Mottramlabs/4-Channel-Mains-Current-Sensor-ESP8266/Pictures/Dims.png

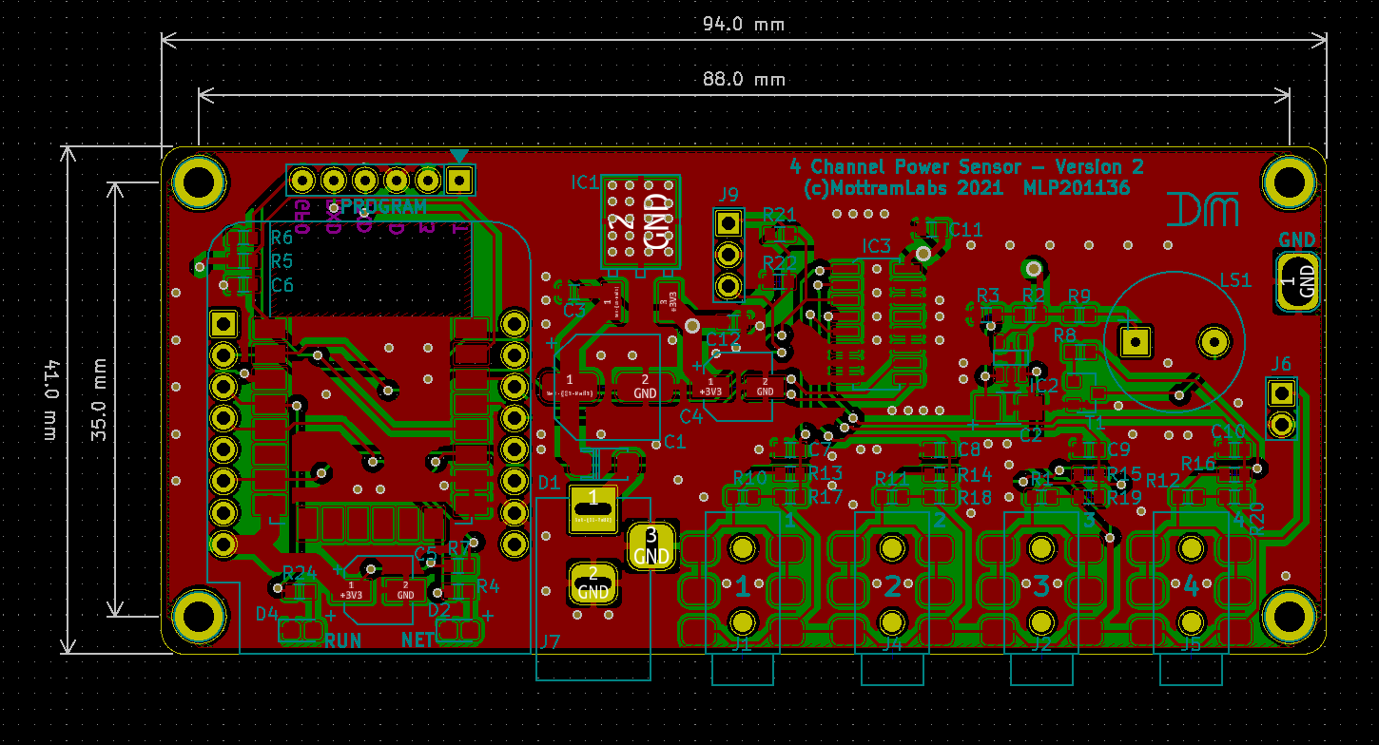
Pictures/Dims.png
