Mottramlabs/4-Channel-Mains-Current-Sensor-ESP8266/SCH201136.pdf

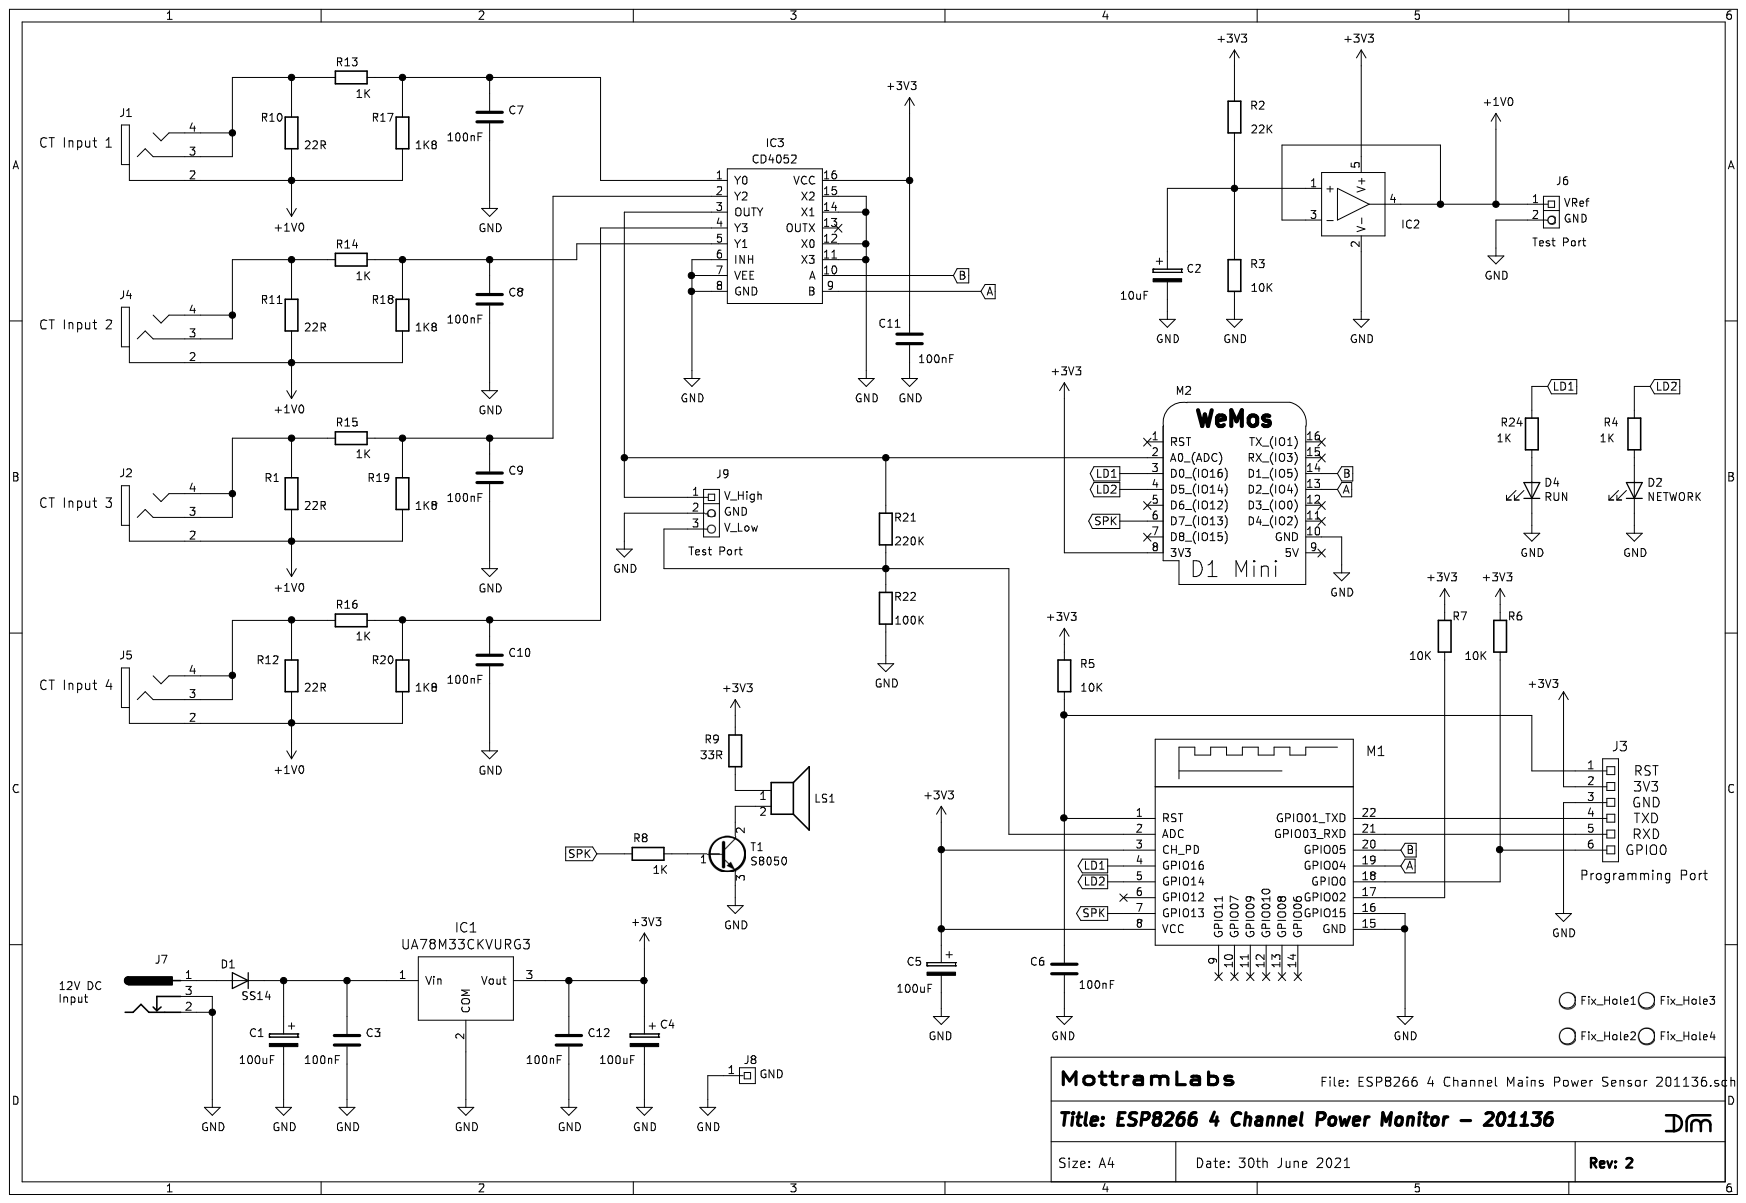
[picture p3: page 1]
