Mottramlabs/4-Channel-Mains-Current-Sensor-ESP8266/(threads)

Thread 1 (2021-08-17):

ESPHome Support

jamestutton, 2021-08-17:
Hi just wondering if you had considered ESPHome support for this module.  They already have CT Clamp Support so would just need some way of working with the multiplexer.

Mottramlabs, 2021-08-22:
I've only just started using ESPHome so still a lot to learn. I have tried my single channel board with the CT Clamp module and it worked well, so now I just need to figure out how to control the GPIO pins used for the multiplexer. I may need help with this, I can't find the source code for the CT Clamp module.

jamestutton, 2021-08-23:
The esphome ct_clamp code is here:

https://github.com/esphome/esphome/tree/5c65f9f9ad8af021f0d73cb0eb12babd2b784c1a/esphome/components/ct_clamp

So again not had the time to deep dive but guessing the basic principle would be set create a fork of this module:

- Set an enabled channels flag.
- Cycle through each enabled channel on the multiplexer by setting correct GPIO states:
- Then have 4 return values that get published.

Or just cycle through all 4 channels with a bit less resolution/refresh time.

jamestutton, 2021-08-23:
Could probably use something like DHT12

https://github.com/esphome/esphome/tree/5c65f9f9ad8af021f0d73cb0eb12babd2b784c1a/esphome/components/dht12

To model the idea of returning multiple values, but instead of temp + humidity you return channel1,2,3,4

GPIO PIN Stuff should be as simple as

```
this->pin_d1->digital_write(true);
this->pin_d2->digital_write(false);

```

daveabbott007, 2021-09-07:
Hi all, i am not a software guy by any means, but through the powers of cut and paste I have managed to work out a dirty workaround to get this board working with ESPhome.
my setup is 100a on ct1 (main feed) and 30a's on ct's 2,3 and 4. (house rings).
please use at your ow risk etc etc and if someone can improve it please share!

`substitutions:
  update_time: never
  disp_name: power-meter
  ic1Volts: "240"

esphome:
  name: power-meter
  platform: ESP8266
  board: d1_mini

logger:
  level: DEBUG
api:
captive_portal:
web_server:
  port: 80
ota:
wifi:
  ssid: "wifi ssid"
  password: "wifi pass"

time:
  - platform: homeassistant
    id: homeassistant_time

#.......................................
#...Below script sets up PIN A and B ...
#......then tells CT# to update.........
#.......................................

interval:
  - interval: 15s
    then:
      - script.execute: readCTs
script:
  - id: readCTs
    then:
    # A	B  CT
    # 0	0  1
    # 1	0  3
    # 0	1  2
    # 1	1  4
    # setup for CT1 A=0 B=0 - ct1Amps
      - output.turn_off: pinA
      - output.turn_off: pinB
      - delay: 2s
      - component.update: ct1Amps
      - delay: 500ms
      - component.update: ct1Watts
      - delay: 500ms
    # setup for CT2 A=1 B=0 - ct2Amps
      - output.turn_off: pinA
      - output.turn_on: pinB
      - delay: 2s
      - component.update: ct2Amps
      - delay: 500ms
      - component.update: ct2Watts
      - delay: 500ms
    # setup for CT3 A=0 B=1 - ct3Amps
      - output.turn_on: pinA
      - output.turn_off: pinB
      - delay: 2s
      - component.update: ct3Amps
      - delay: 500ms
      - component.update: ct3Watts
      - delay: 500ms
    # setup for CT4 A=1 B=1 - ct4Amps
      - output.turn_on: pinA
      - output.turn_on: pinB
      - delay: 2s
      - component.update: ct4Amps
      - delay: 500ms
      - component.update: ct4Watts
      - delay: 500ms

switch:
  - platform: restart
    name: "Restart"

output:
  - platform: gpio
    pin: D1
    id: pinB
  - platform: gpio
    pin: D2
    id: pinA

sensor:
  - platform: wifi_signal
    name: "wifi_signal"
    update_interval: 1min
  - platform: uptime
    name: "uptime"
    id: Uptime
    update_interval: 1min

  - platform: adc
    pin: A0
    id: adc_sensor
#    attenuation: 11db #esp32 only

  - platform: ct_clamp
    sensor: adc_sensor
    name: ct1Amps
    id: ct1Amps
    unit_of_measurement: A
    accuracy_decimals: 5
    sample_duration: 200ms
    update_interval: ${update_time}
    filters:
      - calibrate_linear:
          # Measured value of 0 maps to 0A
          - 0 -> 0
          # Known load: 4.0A
          # Value shown in logs: 0.1333A - 4.79=5.09
          - 0.00358  -> 4.4866

  - platform: ct_clamp
    sensor: adc_sensor
    name: ct2Amps
    id: ct2Amps
    unit_of_measurement: A
    accuracy_decimals: 5
    sample_duration: 200ms
    update_interval: ${update_time}
    filters:
      - calibrate_linear:
          - 0 -> 0
          - 0.00298175  -> 2.060

  - platform: ct_clamp
    sensor: adc_sensor
    name: ct3Amps
    id: ct3Amps
    unit_of_measurement: A
    accuracy_decimals: 5
    sample_duration: 200ms
    update_interval: ${update_time}
    filters:
      - calibrate_linear:
          # Measured value of 0 maps to 0A
          - 0 -> 0
          # Known load: 4.0A
          # Value shown in logs: 0.1333A
          - 0.1333 -> 4.0

  - platform: ct_clamp
    sensor: adc_sensor
    name: ct4Amps
    id: ct4Amps
    unit_of_measurement: A
    accuracy_decimals: 5
    sample_duration: 200ms
    update_interval: ${update_time}
    filters:
      - calibrate_linear:
          # Measured value of 0 maps to 0A
          - 0 -> 0.
          # Known load: 4.0A
          # Value shown in logs: 0.1333A
          - 0.1333 -> 4.0

#Watts per channel
  - platform: template
    name: ${disp_name} CT1 Watts
    id: ct1Watts
    lambda: return id(ct1Amps).state * ${ic1Volts};
    accuracy_decimals: 0
    unit_of_measurement: W
    icon: "mdi:flash-circle"
    update_interval: ${update_time} 
  - platform: template
    name: ${disp_name} CT2 Watts
    id: ct2Watts
    lambda: return id(ct2Amps).state * ${ic1Volts};
    accuracy_decimals: 0
    unit_of_measurement: W
    icon: "mdi:flash-circle"
    update_interval: ${update_time} 
  - platform: template
    name: ${disp_name} CT3 Watts
    id: ct3Watts
    lambda: return id(ct3Amps).state * ${ic1Volts};
    accuracy_decimals: 0
    unit_of_measurement: W
    icon: "mdi:flash-circle"
    update_interval: ${update_time} 
  - platform: template
    name: ${disp_name} CT4 Watts
    id: ct4Watts
    lambda: return id(ct4Amps).state * ${ic1Volts};
    accuracy_decimals: 0
    unit_of_measurement: W
    icon: "mdi:flash-circle"
    update_interval: ${update_time}

#Total Amps
  - platform: template
    name: ${disp_name} Total Amps
    id: totalAmps
    lambda: return id(ct1Amps).state ;
    accuracy_decimals: 2
    unit_of_measurement: A
    icon: "mdi:flash"
    update_interval: 15s 
#Total Watts
  - platform: template
    name: ${disp_name} Total Watts
    id: totalWatts
    lambda: return id(totalAmps).state * 230;
    accuracy_decimals: 1
    unit_of_measurement: W
    icon: "mdi:flash-circle"
    update_interval: 15s
#kWh
  - platform: total_daily_energy
    name: ${disp_name} Total kWh
    power_id: totalWatts
    filters:
      - multiply: 0.001
    unit_of_measurement: kWh

    `

GwelforBodad, 2021-09-29:
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

I don't use Home Assistant but like the idea of being able to enable/disable channels and specify CT parameters without having to recompile the sketch and upload over the air.  Therefore, I'm thinking of putting default values into my code but with the ability to update which channels are enabled and CT parameters using an MQTT configuration topic.  Thanks for the idea.

Morodin8, 2021-11-17:
Hi,
Thanks for the yaml @daveabbott007, tried it but just getting a steady `[D][sensor:113]: 'ct1Amps': Sending state 0.00049 A with 5 decimals of accuracy` with power on & off.
@jamestutton did you have to make any modifactions, apart from wifi etc. to get it working?

Morodin8, 2021-11-21:
Hi,
I tried another D1 mini & it now works. I assume it was my dodgy soldering skills on the other board.
Thanks again @daveabbott007!

scadman1, 2022-04-11:
Hi,

@Morodin8, can you confirm what version of the 4 channel Mottram Labs board this worked on please? Version 1 (Green PCB) or 2 (Blue PCB) or shouldn't it matter?

Morodin8, 2022-04-19:
It was the blue v2 PCB, I don't believe the script is needed for the green v1 PCB but not sure as I don't have the v1.

scadman1, 2022-04-25:
Hi Mondin8, many thanks for clarifying that for me. I now have v2 PCB and it all seems to be working however I'm struggling to get the calibration accurate. I have four SCT-013-000 100A/50mA current transformers. Any direction on this would be very much appreciated.

scadman1, 2022-04-26:
Many thanks again for the response. I'm extremely new to ESP programming and I think I may have taken on a little more than maybe I should have. I think I have something wrong with my code as it seems to add the values of the CT's together. Even without clipping them over the wire I'm getting power readings back unless they are set without filtering.

scadman1, 2022-04-28:
Hi Mondin8, are you using the Version 2 board with a D1 Mini ESP32? I ask as according to the ESPHome documentation, **The Analog To Digital (adc) Sensor allows you to use the built-in ADC in your device to measure a voltage on certain pins. On the ESP8266 only pin A0 (GPIO17) supports this. On the ESP32 pins GPIO32 through GPIO39 can be used.** I think that might explain why I can only get an accumulative value.

Morodin8, 2022-04-30:
I'm using the v2 board with ESP8266, that is why @daveabbott007's script is nescasary.

```
substitutions:
  pin_set_delay: 1s
  component_update_delay: 450ms
  update_time: 8s # must be > (pin_set_delay+component_update_delay*2) * channels

#.......................................
#...Below script sets up PIN A and B ...
#......then tells CT# to update.........
#.......................................

interval:
  - interval: ${update_time}
    then:
      - script.execute: readCTs
script:
  - id: readCTs
    then:
    # A	B:  CT
    # 0	0:  1
    # 0	1:  2
    # 1	0:  3
    # 1	1:  4
    # setup for CT1 A=0 B=0 - ct1Amps
      - output.turn_off: pinA
      - output.turn_off: pinB
      - delay: ${pin_set_delay}
      - component.update: ct1Amps
      - delay: ${component_update_delay}
      - component.update: ct1Watts
      - delay: ${component_update_delay}
    # setup for CT2 A=0 B=1 - ct2Amps
      - output.turn_off: pinA
      - output.turn_on: pinB
      - delay: ${pin_set_delay}
      - component.update: ct2Amps
      - delay: ${component_update_delay}
      - component.update: ct2Watts
      - delay: ${component_update_delay}
    # setup for CT3 A=1 B=0 - ct3Amps
      - output.turn_on: pinA
      - output.turn_off: pinB
      - delay: ${pin_set_delay}
      - component.update: ct3Amps
      - delay: ${component_update_delay}
      - component.update: ct3Watts
      - delay: ${component_update_delay}
    # setup for CT4 A=1 B=1 - ct4Amps
      - output.turn_on: pinA
      - output.turn_on: pinB
      - delay: ${pin_set_delay}
      - component.update: ct4Amps
      - delay: ${component_update_delay}
      - component.update: ct4Watts
      - delay: ${component_update_delay}

output:
  - platform: gpio
    pin: D1
    id: pinB
  - platform: gpio
    pin: D2
    id: pinA

sensor:
  - platform: adc
    pin: A0
    id: adc_sensor
```

scadman1, 2022-04-30:
Thank you so much, it was about the timings.

Morodin8, 2022-04-30:
No problem, glad to help.

jimmyeao, 2022-08-09:
Can someone share the full ESPHOME yaml please? I'm struggling to get it validated :/

IanQuilter, 2022-10-22:
I'm also trying to get this to work with a new v3 board with a ESP8266 D1 Mini attached.

All CT's give a low value reading with no current flowing in the wires with the current clamps on them. With a load connected drawing approximately 4amps CT1 and CT2 will give readings, although they are not correct and are wildly different from each other, CT1 is about 8 amps and CT2 is about 3.4 amps. The CT3 and CT4 reading don't change in value from when no current is flowing.

I've tested all the current transformers by plugging them into CT1 and CT2 in turn and all of them are working and give about the same value for the current flow so it's not a problem with the current transformers.

I used the code that  daveabbott007 supplied and that jamestutton confirmed was working. I'm using the same combination of current transformers that daveabbott007 was using  so I expected it to work.

I'm going to look through the code and see if the snippets of code Morodin8 supplied will solve it.

jjvelar, 2022-11-22:
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

Hi everyone,
Is there an ESPHome configuration for the new 1V/50mA, 1 CT clamp board?
I am struggling a lot in getting meaningful readings:
- ct_clamp sensor value when there is no current is 0.2-0.3A without calibration. I was expecting 0.00x values...
- as I am using a Wemos D1 Mini board, I multiply adc_sensor value by 3.3 as per ESPHome documentation, but not sure it is working
- I get negative adc_sensor values. That's why I had to offset it by -1.65
- despite my CT clamp is 100A:50mA, I have to set the jumper in the 1V and not in the 50mA position to get readings
- I get the maximum voltage value from the adc_sensor with a load of just 8-9 amps, but the CT clamp can handle up to 100!

Here you've got my sensors configuration.
Any help will be greatly appreciated.

sensor:
  # The grid voltage entity from Home Assistant
  - platform: homeassistant
    name: "Grid Voltage Entity from Home Assistant"
    entity_id: '${homeassistant_grid_voltage_entity}'
    id: grid_voltage
    internal: true

  # The power sensor
  - platform: template
    name: "Potencia Vitrocerámica"
    id: vitroceramica_potencia
    unit_of_measurement: "W"
    device_class: power
    accuracy_decimals: 1
    icon: "mdi:flash"

  # Raw current sensor
  - platform: ct_clamp
    sensor: adc_vitroceramica
    name: "Corriente Vitrocerámica Raw"
    id: vitroceramica_corriente_raw
    update_interval: 5s
    unit_of_measurement: "A"
    device_class: current
    accuracy_decimals: 6
    icon: "mdi:current-ac"

  # The current sensor
  - platform: ct_clamp
    sensor: adc_vitroceramica
    name: "Corriente Vitrocerámica"
    id: vitroceramica_corriente
    update_interval: 5s
    unit_of_measurement: "A"
    device_class: current
    accuracy_decimals: 2
    icon: "mdi:current-ac"
    filters:
      - calibrate_linear:
        - 0.25 -> 0.0
        - 0.37 -> 7.9
      - lambda: return min(max(round(x*100.0)/100.0,0.0),50.0); #redondeo a 2 decimales. Siempre mayor que '0 A' y menor que '50 A'
    on_value:
      then:
        - script.execute: flash_led
        - sensor.template.publish:
            id: vitroceramica_potencia
            state: !lambda 'return x*id(grid_voltage).state;'

  - platform: adc
    pin: A0
    id: adc_vitroceramica
    name: "adc_vitroceramica"
    update_interval: 5s
    filters:
      - multiply: 3.3 #Wemos D1 mini includes external voltage divider circuitry to scale down a 3.3V input signal to the chip-internal 1.0V
      - offset: -1.65 #shift down by 3.3V/2=1.65V
      - median:
          window_size: 12
          send_every: 1
          send_first_at: 1

light:
  - platform: binary
    name: "Led Potencia Vitroceramica"
    id: led_potencia_vitroceramica
    output: led_potencia_vitroceramica_output
    internal: true
    
script:
  - id: flash_led
    then:
      - light.turn_on:
          id: led_potencia_vitroceramica
      - delay: 100ms
      - light.turn_off:
          id: led_potencia_vitroceramica

dacorn, 2022-12-18:
>

HI Ian, did you get this working with the V3 board? I can not get it working.

IanQuilter, 2022-12-18:
Hello Dave
I see from your post on the Home Assistant forum that you are using the v3 green board. I have the v3 blue board, which is why I didn't reply to your post as the green board uses different Esp code.
In case it helps you, the problem I had using the daveabbott007 code was that his calibration figures were very wrong for my use and caused no current values to show on the CT3 and 4 inputs. I removed his calibration figures and it then gave current values. I then just had to follow the instructions on how to calibrate all of my sensors.
The only minor, but annoying, issue I still have is that when no current is flowing my sensors give a varying low current value. Not sure if it's due to the cheap Chinese SCT-013 current clamps I used or the circuit design.
The other thing to note is that his code was for a 3 phase supply and his total power figures only sum inputs 1-3. If you are using all 4 inputs on single phase you need to change the code to sum all 4.
Hope it helps.

nickdos, 2023-01-11:
Hi @IanQuilter, are you able to share your esphome yaml code here? I've got the v3 blue version and want to use it for monitoring separate inputs (single phase) too, plus I'm using SCT-013 CTs from Aliexpress as well - so your settings will be very close to what I'm after...

Morodin8, 2023-01-11:
> Can someone share the full ESPHOME yaml please? I'm struggling to get it validated :/

Sorry, meant to reply to this. @IanQuilter request prometed me to do it.

```
substitutions:
  device_name: emon
  pin_set_delay: 1s
  component_update_delay: 450ms
  update_time: 8s # must be > (pin_set_delay+component_update_delay*2) * channels
  ct_update_time: never
  ic1Volts: '230'
# filters
  intoZero: '0.0005' # '0.00049'
  # known load in Amps (known Watts / Volts)
  known125w: '0.544'
  known900w: '3.913'
  known2300w: '10.0'
  known3300w: '14.348'
  known6000w: '26.09'
  # value in logs
  logs125w: '0.005' # '0.0085', '0.0035', 0.00134'
  logs900w: '0.009' # '0.006', 0.0055'
  logs2300w: '0.0157' # '0.01'
  logs3300w: '0.022' # '0.023', '0.025'
  logs6000w: '0.045' # '0.047'

esphome:
  name: ${device_name}
  compile_process_limit: 1

esp8266:
  board: d1_mini

wifi:
  ssid: !secret wifi_ssid
  password: !secret wifi_password
  manual_ip:
    static_ip: !secret emon_static_ip
    gateway: !secret wifi_gateway
    subnet: !secret wifi_subnet

  # Enable fallback hotspot (captive portal) in case wifi connection fails
  ap:
    ssid: !secret emon_fallback_ssid
    password: !secret esp_fallback_password

# Enable Home Assistant API
api:
  password: !secret api_password

ota:
  password: !secret ota_password

# Enable Web server.
web_server:
  port: 80

# Enable logging
logger:

captive_portal:

# Time used for daily KWh usage
time:
  - platform: homeassistant
    id: homeassistant_time

#.......................................
#...Below script sets up PIN A and B ...
#......then tells CT# to update.........
#.......................................

interval:
  - interval: ${update_time}
    then:
      - script.execute: readCTs

script:
  - id: readCTs
    then:
    # A	B  CT
    # 0	0  1
    # 0	1  2
    # 1	0  3
    # 1	1  4
    # setup for CT1 A=0 B=0 - ct1Amps
      - output.turn_off: pinA
      - output.turn_off: pinB
      - delay: ${pin_set_delay}
      - component.update: ct1Amps
      - delay: ${component_update_delay}
      - component.update: ct1Watts
      - delay: ${component_update_delay}
    # setup for CT2 A=0 B=1 - ct2Amps
      - output.turn_off: pinA
      - output.turn_on: pinB
      - delay: ${pin_set_delay}
      - component.update: ct2Amps
      - delay: ${component_update_delay}
      - component.update: ct2Watts
      - delay: ${component_update_delay}
    # setup for CT3 A=1 B=0 - ct3Amps
      - output.turn_on: pinA
      - output.turn_off: pinB
      - delay: ${pin_set_delay}
      - component.update: ct3Amps
      - delay: ${component_update_delay}
      - component.update: ct3Watts
      - delay: ${component_update_delay}
    # setup for CT4 A=1 B=1 - ct4Amps
      - output.turn_on: pinA
      - output.turn_on: pinB
      - delay: ${pin_set_delay}
      - component.update: ct4Amps
      - delay: ${component_update_delay}
      - component.update: ct4Watts
      - delay: ${component_update_delay}

text_sensor:
  - platform: wifi_info
    ip_address:
      name: ${device_name} IP Address
      disabled_by_default: true

output:
  - platform: gpio
    pin: D1
    id: pinB
  - platform: gpio
    pin: D2
    id: pinA

sensor:
  - platform: wifi_signal
    name: ${device_name} Wifi Signal
    update_interval: 60s
  - platform: uptime
    name: ${device_name} Uptime
    unit_of_measurement: days
    update_interval: 300s
    accuracy_decimals: 2
    filters:
      - multiply: 0.000011574
    id: Uptime

  - platform: adc
    pin: A0
    id: adc_sensor
    update_interval: ${update_time}
#    attenuation: 11db #esp32 only

# smart plug
# Washing
  - platform: homeassistant
    id: plug0Power
    entity_id: sensor.athom_smart_plug_power
    on_value:
      then:
        - sensor.template.publish:
            id: washingWatts
            state: !lambda 'if (id(plug0Power).state > 0) return id(plug0Power).state; else return 0;'

#Apms
# Channel 1: Solar
  - platform: ct_clamp
    sensor: adc_sensor
    name: ct1Amps, solar
    id: ct1Amps
    unit_of_measurement: A
    device_class: current
    accuracy_decimals: 5
    sample_duration: 200ms
    update_interval: ${ct_update_time}
    filters:
      - calibrate_linear:
          - ${intoZero} -> 0
          - ${logs125w} -> ${known125w}
          - ${logs900w} -> ${known900w}
          - ${logs2300w} -> ${known2300w}
          - ${logs3300w} -> ${known3300w}
          - ${logs6000w} -> ${known6000w}
      # filter nagative
      - lambda: |-
          if (x > 0) return x;
          else return 0;
    # When Current updates, update Watts
    on_value:
      then:
        - sensor.template.publish:
            id: ct1Watts
            state: !lambda 'return id(ct1Amps).state * ${ic1Volts};'

# Channel 2: EV
  - platform: ct_clamp
    sensor: adc_sensor
    name: ct2Amps, EV
    id: ct2Amps
    unit_of_measurement: A
    device_class: current
    accuracy_decimals: 5
    sample_duration: 200ms
    update_interval: ${ct_update_time}
    filters:
      - calibrate_linear:
          - ${intoZero} -> 0
          - ${logs125w} -> ${known125w}
          - ${logs900w} -> ${known900w}
          - ${logs2300w} -> ${known2300w}
          - ${logs3300w} -> ${known3300w}
          - ${logs6000w} -> ${known6000w}
      # filter less than 920W, equates no power throughput
      - lambda: |-
          if (x > 4) return x;
          else return 0;
    # When Current updates, update Watts
    on_value:
      then:
        - sensor.template.publish:
            id: ct2Watts
            state: !lambda 'return id(ct2Amps).state * ${ic1Volts};'
        - sensor.template.publish:
            id: ctNetWatts
            state: !lambda 'return id(ct2Watts).state + id(ct4Watts).state + id(ct3Watts).state + id(washingWatts).state;'

# Channel 3: Dryer
  - platform: ct_clamp
    sensor: adc_sensor
    name: ct3Amps, dryer
    id: ct3Amps
    unit_of_measurement: A
    device_class: current
    accuracy_decimals: 5
    sample_duration: 200ms
    update_interval: ${ct_update_time}
    filters:
      - calibrate_linear:
          - ${intoZero} -> 0
          - ${logs2300w} -> ${known2300w}
      # filter less than 920W, equates no power throughput
      - lambda: |-
          if (x > 4) return x;
          else return 0;
    # When Current updates, update Watts
    on_value:
      then:
        - sensor.template.publish:
            id: ct3Watts
            state: !lambda 'return id(ct3Amps).state * ${ic1Volts};'
        - sensor.template.publish:
            id: ctNetWatts
            state: !lambda 'return id(ct2Watts).state + id(ct4Watts).state + id(ct3Watts).state + id(washingWatts).state;'

# Channel 4: House
  - platform: ct_clamp
    sensor: adc_sensor
    name: ct4Amps, house
    id: ct4Amps
    unit_of_measurement: A
    device_class: current
    accuracy_decimals: 5
    sample_duration: 200ms
    update_interval: ${ct_update_time}
    filters:
      - calibrate_linear:
          - ${intoZero} -> 0
          - ${logs125w} -> ${known125w}
          - ${logs900w} -> ${known900w}
          - ${logs2300w} -> ${known2300w}
          - ${logs3300w} -> ${known3300w}
          - ${logs6000w} -> ${known6000w}
      # filter nagative
      - lambda: |-
          if (x > 0) return x;
          else return 0;
    # When Current updates, update Watts
    on_value:
      then:
        - sensor.template.publish:
            id: ct4Watts
            state: !lambda 'x = (id(ct4Amps).state * ${ic1Volts}) - id(ct3Watts).state - id(washingWatts).state; if (x > 0) return x; else return 0;'
        - sensor.template.publish:
            id: ctNetWatts
            state: !lambda 'return id(ct2Watts).state + id(ct4Watts).state + id(ct3Watts).state + id(washingWatts).state;'

# Watts
# Washing
  - platform: template
    name: ${device_name} Washing watts
    id: washingWatts
    accuracy_decimals: 0
    unit_of_measurement: W
    device_class: power
    icon: "mdi:flash-circle"
    update_interval: ${ct_update_time}
# Solar
  - platform: template
    name: ${device_name} Solar watts
    id: ct1Watts
    accuracy_decimals: 0
    unit_of_measurement: W
    device_class: power
    icon: "mdi:flash-circle"
    update_interval: ${ct_update_time}
# EV
  - platform: template
    name: ${device_name} EV watts
    id: ct2Watts
    accuracy_decimals: 0
    unit_of_measurement: W
    device_class: power
    icon: "mdi:flash-circle"
    update_interval: ${ct_update_time}
# Dryer
  - platform: template
    name: ${device_name} Dryer watts
    id: ct3Watts
    accuracy_decimals: 0
    unit_of_measurement: W
    device_class: power
    icon: "mdi:flash-circle"
    update_interval: ${ct_update_time}
# House
  - platform: template
    name: ${device_name} House watts
    id: ct4Watts
    accuracy_decimals: 0
    unit_of_measurement: W
    device_class: power
    icon: "mdi:flash-circle"
    update_interval: ${ct_update_time}
# Net
  - platform: template
    name: ${device_name} Net watts
    id: ctNetWatts
    accuracy_decimals: 0
    unit_of_measurement: W
    device_class: power
    icon: "mdi:flash-circle"
    update_interval: ${update_time}

# kWh
# Solar
  - platform: total_daily_energy
    name: ${device_name} Daily Solar kWh
    power_id: ct1Watts
    filters:
      - multiply: 0.001
    unit_of_measurement: kWh

# EV
  - platform: total_daily_energy
    name: ${device_name} Daily EV kWh
    power_id: ct2Watts
    filters:
      - multiply: 0.001
    unit_of_measurement: kWh

# Dryer
  - platform: total_daily_energy
    name: ${device_name} Daily Dryer kWh
    power_id: ct3Watts
    filters:
      - multiply: 0.001
    unit_of_measurement: kWh

# House
  - platform: total_daily_energy
    name: ${device_name} Daily House kWh
    power_id: ct4Watts
    filters:
      - multiply: 0.001
    unit_of_measurement: kWh

# Net
  - platform: total_daily_energy
    name: ${device_name} Daily Net kWh
    power_id: ctNetWatts
    filters:
      - multiply: 0.001
    unit_of_measurement: kWh

# Price
# Electricity
  - platform: template
    name: ${device_name} electricity price
    id: electricityPrice
    accuracy_decimals: 4
    unit_of_measurement: £/kWh
    device_class: monetary
    icon: "mdi:currency-gbp"
    update_interval: 3600s
    lambda: return 0.2019;

# Gas
  - platform: template
    name: ${device_name} gas price
    id: gasPrice
    accuracy_decimals: 4
    unit_of_measurement: £/kWh
    device_class: monetary
    icon: "mdi:currency-gbp"
    update_interval: 3600s
    lambda: return 0.0418;
```

IanQuilter, 2023-01-11:
> Hi @IanQuilter, are you able to share your esphome yaml code here? I've got the v3 blue version and want to use it for monitoring separate inputs (single phase) too, plus I'm using SCT-013 CTs from Aliexpress as well - so your settings will be very close to what I'm after...

I've pasted a copy of the code I'm using below. I've removed my SSID's and passwords etc from it and added comments about what you need to enter or change. The code is copied from the code posted by daveabbott007. I changed it to sum all 4 readings for the total figures instead of just the 3 he was using.

You will need to comment
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

Thread 2 (2021-09-24):

Calibration and Measurement Units

GwelforBodad, 2021-09-24:
Hi David, the MLP201136 which I bought this week is now in service with a single 100A/50mA CT while I await delivery of the other CTs.  This CT is on the main feed into the distribution board and the values returned vary from about 15 to 40, presumably as things turn on and off, although it could be partly noise?

How do I relate the values being returned via MQTT to the current flowing in the main conductor?  It's a basic question but I'm not sure from the schematic and code what to do with the value to make it meaningful.  I read an independent report on the performance of these CTs and they appear to offer excellent linearity from zero to rated current, so the challenge is to do the sampling and calculations which best capture the measured values.

There's also the issue of calibration.  The sketch has a "Default calibration value for the MLP201136 Power Measurement PCB" of 1500.  How would I know how to adjust this for the CT?  I guess this is all tied in with the other things which can be adjusted such as "low-pass filter output, one per channel. 320 is a good place to start".

I'd happily help to write a setup/calibration wiki with you but don't have your knowledge about the device.

Thanks,  Tim

Thread 5 (2022-09-13):

Is it possible to write code that will give a "direction" for the CT clamp?

CaribouJohn, 2022-09-13:
I'd like to sense whether my PV system is importing or exporting to the grid  and I am unsure of whether the board is capable of doing this.

I understand that RMS will be a positive value whatever the flow and thats fine as it stands.  I did try reversing the clamps and the output remained positive. I also do see the values change as the load in the house changes. Do you have a recommendation on how I can get the flow direction into and out of my home?

nlscarter, 2022-11-02:
My (limited) understanding is that this just isn't possible with a CT clamp, you would be better off reading usage and generation then summing it to understand import or export.
